blessedBA/sorting-warehouse/project_information/README.md

# Определение цвета предмета на фото и с веб-камеры

Первая версия для мини-склада: Python + OpenCV, без обучения нейросети.
Программа выделяет один светлый или цветной предмет на чёрном конвейере
и определяет его цвет, исключая фон.

## Установка и запуск

Нужен Python 3.10 или новее. В терминале из каталога проекта:

```bash
python3 -m venv .venv
source .venv/bin/activate
python -m pip install -r requirements.txt
python color_detector.py
```

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

Положите фотографии в папку `photos/` рядом с программой и запускайте без аргументов:

```bash
.venv/bin/python color_detector.py
```

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

При необходимости можно по-прежнему указать отдельную фотографию или другую папку:

```bash
python color_detector.py "/путь/к/фотографии.jpeg"
python color_detector.py "/путь/к/папке"
```

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

Например:

```text
output/
  ph_09.18 10.35/
    ph_09.18 10.35_result.jpg
    ph_09.18 10.35_mask.png
    ph_09.18 10.35_result.json
  ph_09.18 10.37/
    ph_09.18 10.37_result.jpg
    ph_09.18 10.37_mask.png
    ph_09.18 10.37_result.json
```

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

## Как выбирается предмет

Алгоритм рассчитан на **чёрный фон**. Чёрная лента при освещении может выглядеть
серой, поэтому порог яркости подбирается по снимку методом Оцу, но не опускается
ниже 95 по шкале 0…255. Светлые пиксели выше порога считаются кандидатами на предмет.
Насыщенные цветные пиксели выделяются дополнительно: насыщенность от 65,
яркость от 65, разница максимального и минимального канала от 40.
Это помогает находить, например, тёмно-синий предмет на тёмной ленте.

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

```bash
python color_detector.py photo.jpg --roi 100 600 1700 950
```

Это пример координат для крупного снимка; для своего изображения их нужно подобрать.

## Как определяется цвет

После выделения объекта программа немного отступает от его контура и переводит
пиксели в HSV. Цветовой тон определяет красный, оранжевый, жёлтый, зелёный,
голубой, синий, фиолетовый, розовый и коричневый. Яркость и насыщенность позволяют
отдельно выделять чёрный, серый и белый. Побеждает наиболее частый класс.
Пороговые значения находятся в функции `classifyPixels` в `color_detector.py`.

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

Это прототип для одного хорошо различимого предмета на чёрном фоне.
Чёрные предметы и почти чёрные участки исключаются вместе с фоном; первый пример
с чёрной мышкой на светлом столе больше не соответствует рабочему режиму.
Сильные блики на ленте, цветное освещение, малый контраст, прозрачные предметы
и яркий мусор могут приводить к ошибкам. Пороги нужно проверить на реальных
образцах при освещении склада. Если предмет касается края, он исключается;
дождитесь его полного появления в рабочей области.
Сначала проверяйте маску — она показывает, какой участок анализируется.

## Веб-камера: живое изображение с обводкой

Запуск из каталога проекта:

```bash
.venv/bin/python camera_detector.py
```

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

В окне камеры доступны клавиши (английская раскладка):

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

По умолчанию используется камера **0**. Если открылась встроенная камера вместо
подключённой веб-камеры, попробуйте:

```bash
.venv/bin/python camera_detector.py --camera 1
```

Индекс может быть 0, 1, 2 и т. д. Для меньшей нагрузки можно запросить 640×480:

```bash
.venv/bin/python camera_detector.py --camera 0 --width 640 --height 480
```

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

```bash
.venv/bin/python camera_detector.py --roi 100 50 600 400
.venv/bin/python main.py --port COM3 --weight-scale=123.45 --roi 100 50 600 400
```

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

### Фильтрация шума камеры

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

Пример более строгих настроек для живого просмотра:

```bash
.venv/bin/python camera_detector.py --min-area-fraction 0.005 --min-width 12 --min-height 12 --confirmation-frames 5
```

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

```bash
.venv/bin/python -m pip uninstall -y opencv-python-headless
.venv/bin/python -m pip install --upgrade -r requirements.txt
```

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

## Общая обработка фото и видео

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

## API камеры

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

```python
from camera import Camera

camera = Camera(camera_index=0, roi=(100, 60, 300, 300))
try:
    result = camera.detectObject()
    if result is not None:
        print(result["color"], result["rgb"], result["bbox"])
finally:
    camera.disconnect()
```

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

## API оборудования

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

```python
from hardware import Hardware

hardware = Hardware(com_port="COM3", baudrate=115200)
try:
    hardware.zero()
    responses = hardware.goto(10, 20)
    hardware.waitForMovement()
    print(responses)
finally:
    hardware.disconnect()
```

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

### Запуск сортировки из контроллера

Контроллер может запускать цикл `main.py` в фоне на уже открытом соединении:

```bash
.venv/bin/python controller.py --port /dev/cu.usbserial-3120 --weight-scale=123.45
```

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

```text
main start
weight fast continuous
```

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

## HX711: подключение и калибровка

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

## Главный цикл сортировки

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

```bash
.venv/bin/python main.py --port COM3 --camera 0 --feed-duration 0.8 --weight-duration 4 --weight-scale=123.45
```

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

## Проверка

```bash
.venv/bin/python -m unittest discover -s tests -v
```

Тесты проверяют основные цвета на чёрном фоне, тонкий белый предмет на текстурном
коврике с неравномерным освещением и светлыми краями, тёмные насыщенные цвета,
исключение чёрных отверстий, выбор предмета через ROI, разноцветный предмет,
пустой кадр и неверные координаты.
Проверки видеорежима используют последовательности искусственных кадров:
исчезновение предмета и смену цвета, сохранение снимков, отключение камеры и выход.
Фильтры шума проверяются на обоих фонах: мелкие постоянные пятна, короткие вспышки,
плавное движение, скачки положения/размера/цвета, сброс при потере кадра,
переподключении и изменении ROI/разрешения, а также настройка порогов.
Они не заменяют проверку изображения и разрешений на физической веб-камере.
Проверки главного цикла используют имитацию устройств: порядок операций,
поиск на пустой ленте и пропуск поиска при уже видимом предмете, подтверждение
реальным детектором на искусственных кадрах, повторение цикла, ошибки подачи
и движения, настройка времени, прерывание и освобождение оборудования.
Весовые тесты проверяют границы 5/12 г, выбор ячейки нужного ряда, усреднение
за заданное время, остановку ленты до измерения и подачу только после него,
ошибки и прерывание измерения до подачи, тарирование, калибровку, частичные ответы,
таймауты и восстановление serial-протокола. `test_firmware.py` компилирует
настоящий скетч с имитацией GPIO/Serial (нужен C++ компилятор) и проверяет
24-битные знаковые значения, старт, измерения, ошибки и отмену.
Эти тесты не заменяют калибровку и проверку физических весов.
