blessedBA/sorting-warehouse/electronics/kicad/README.md

# Схема склада в KiCad

Копия проекта от 17 октября 2026 года с четырьмя символами готовых
модулей. Открывайте `sorting-warehouse.kicad_pro`, затем редактор схемы.

- `U1` — `LM2596_Module`, понижающий преобразователь: два входных и два выходных
  контакта. Размещён вверху слева.
- `U2` — `MX1508_Module`, один канал двигателя конвейера: питание, два управляющих
  входа и два контакта двигателя. Размещён справа под A4988.
- `M1` — `SG90_Module`, сервопривод в виде жёлтого прямоугольника. Три вывода
  `SIG`, `V+`, `GND` сохраняют прежнюю нумерацию и точки подключения.
- `J_HX711` — `HX711_Module`, жёлтый прямоугольник вместо шестиконтактного
  разъёма. Сохранены шесть контактов `Pin_1`–`Pin_6`; их реальное назначение
  предстоит сверить с купленным модулем.

Это символы целых модулей с уже установленными деталями. Новые модули пока
не соединены проводами. Настройки проекта, существующие элементы, соединения,
файл платы и библиотека монтажных отверстий скопированы из исходного проекта.

## Выводы

| Модуль | Номер в символе | Имя | Назначение |
|---|---:|---|---|
| U1 | 1 | IN+ | Положительный вход питания |
| U1 | 2 | IN- | Отрицательный вход питания |
| U1 | 3 | OUT+ | Положительный выход питания |
| U1 | 4 | OUT- | Отрицательный выход питания |
| U2 | 1 | VIN+ | Питание драйвера двигателя |
| U2 | 2 | GND | Общий провод драйвера |
| U2 | 3 | IN1 | Первый управляющий вход |
| U2 | 4 | IN2 | Второй управляющий вход |
| U2 | 5 | OUT1 | Первый контакт двигателя |
| U2 | 6 | OUT2 | Второй контакт двигателя |

Нумерация логическая: она не задаёт физический порядок контактов на купленных
платах и не совпадает с нумерацией выводов отдельных микросхем. Посадочные места
не назначены. Перед разводкой нужно измерить модули и сопоставить эти номера
с площадками их посадочных мест. Выходное напряжение понижайки и напряжение
питания драйвера этим символом не задаются.

## Повторное добавление модулей

Библиотека `Warehouse_Modules.kicad_sym` подключена локально через
`sym-lib-table`. В редакторе схем нажмите **A**, найдите `LM2596_Module`,
`MX1508_Module`, `SG90_Module` или `HX711_Module` и разместите экземпляр.
Выводы, имена и обозначение уже входят
в символ и перемещаются вместе. При переносе проекта сохраняйте библиотеку
и `sym-lib-table` рядом с `.kicad_pro`.

Для подключения нажмите **W** у нужного вывода; метку цепи добавьте клавишей
**L**. Перемещение символа — **M**, перемещение с сохранением проводов — **G**.

## Проверка

KiCad CLI 10.0.7 успешно экспортировал схему и библиотечные символы в SVG,
а схему — в список соединений. Все прежние соединения совпадают с исходными.
Число выводов и их названия проверены по экспортированному списку соединений.

ERC не пройден: схема ещё не соединена полностью. После изменения оформления
HX711 и сервопривода осталось 97 замечаний. Число выводов и их номера сохранены,
а список соединений совпадает с версией до изменения оформления.
