blessedBA/sorting-warehouse/project_information/photo_2026-11-12 21.13.13.jpeg

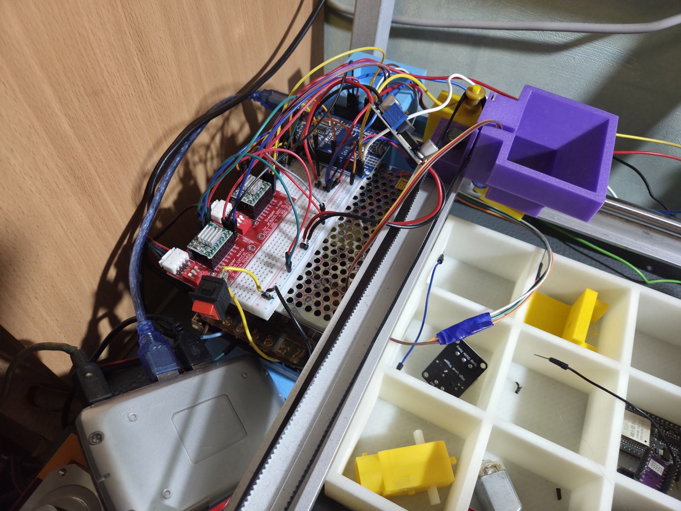
project_information/photo_2026-11-12 21.13.13.jpeg
