blessedBA/sorting-warehouse/CAD&blueprints/V7/Print/Head.stp

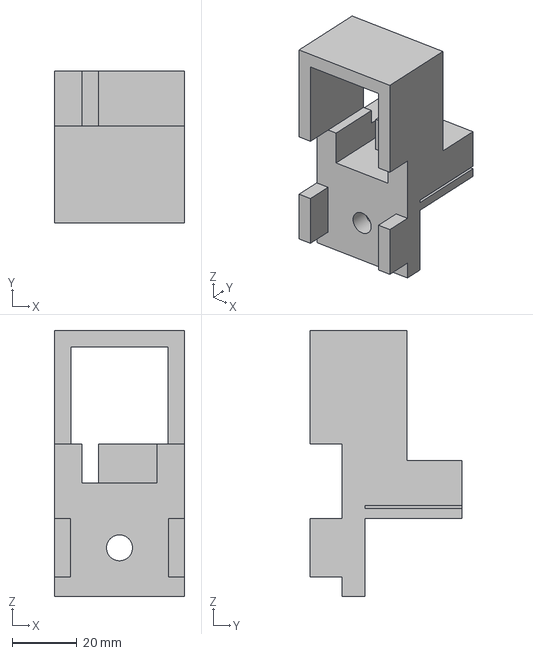
[picture p13: CAD file, 2026-09-20]
CAD&blueprints/V7/Print/Head.stp
40.1 x 47.0 x 82.0 mm
