blessedBA/sorting-warehouse/CAD&blueprints/V7/Print/Conveyor_support.stp

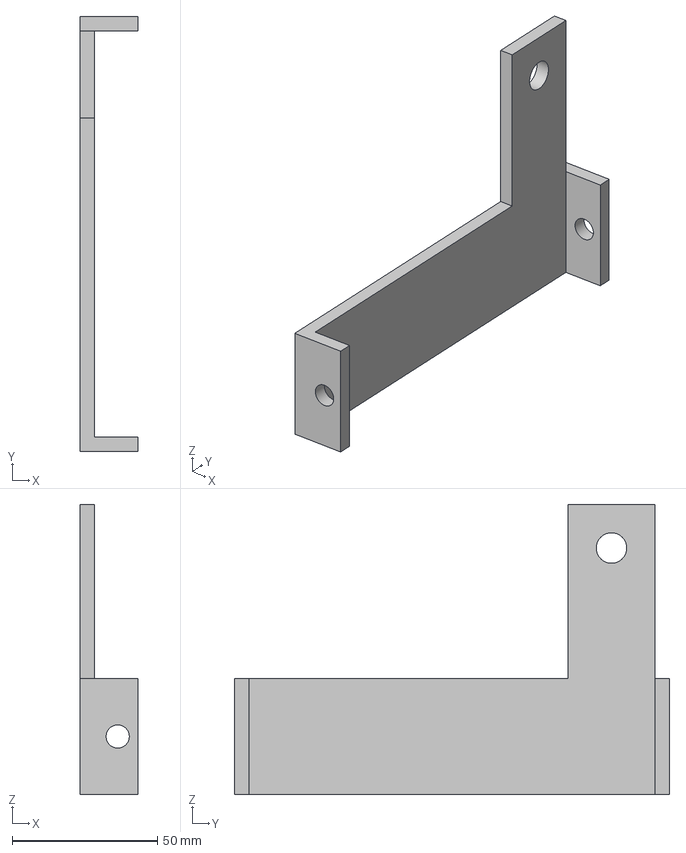
[picture p14: CAD file, 2026-09-20]
CAD&blueprints/V7/Print/Conveyor_support.stp
20.0 x 150.0 x 100.0 mm
