blessedBA/sorting-warehouse/CAD&blueprints/V7/Print/Conveyor_cylinder.stp

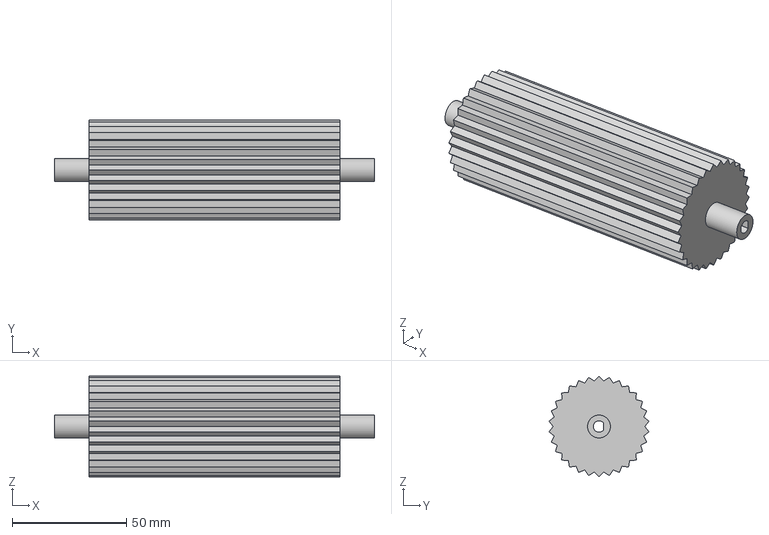
[picture p15: CAD file, 2026-09-20]
CAD&blueprints/V7/Print/Conveyor_cylinder.stp
140.0 x 43.8 x 44.0 mm
