blessedBA/sorting-warehouse/CAD&blueprints/V2/Print/HeadRail.stp

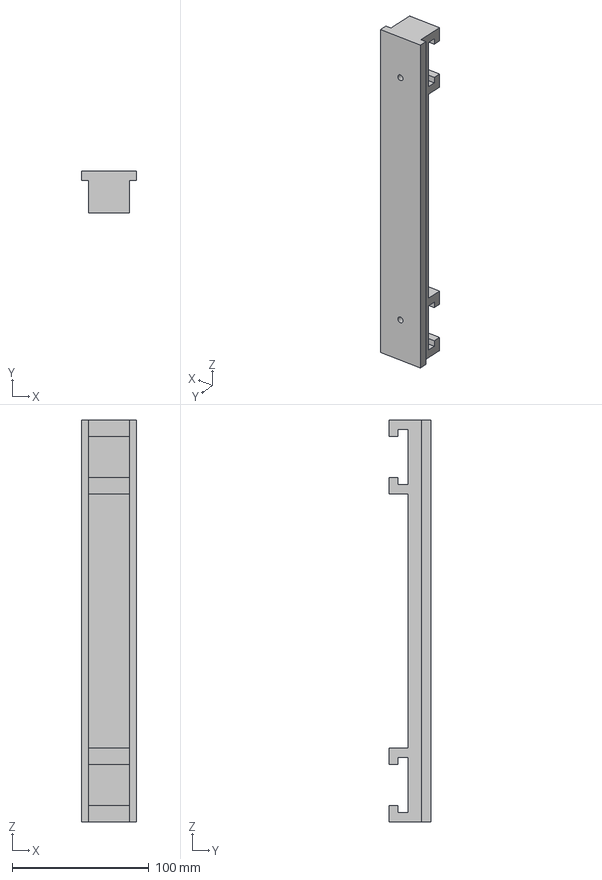
[picture p16: CAD file, 2026-09-20, an earlier design]
CAD&blueprints/V2/Print/HeadRail.stp
40.0 x 31.0 x 294.2 mm
