blessedBA/sorting-warehouse/CAD&blueprints/V3/Print/Base.stp

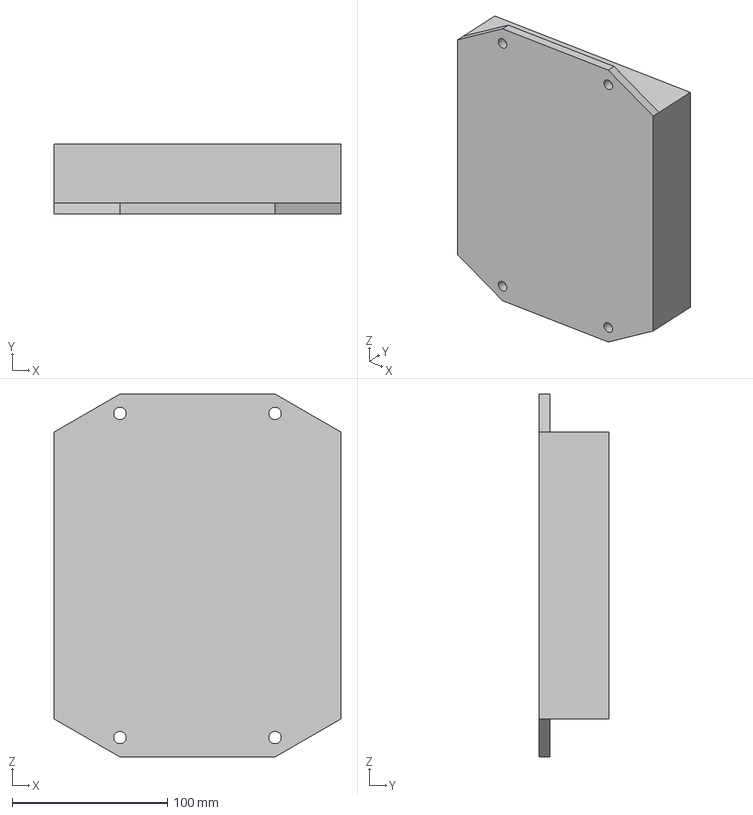
[picture p17: CAD file, 2026-09-20, an earlier design]
CAD&blueprints/V3/Print/Base.stp
185.0 x 45.0 x 234.1 mm
