blessedBA/sorting-warehouse/CAD&blueprints/V5/Print/Cube.stp

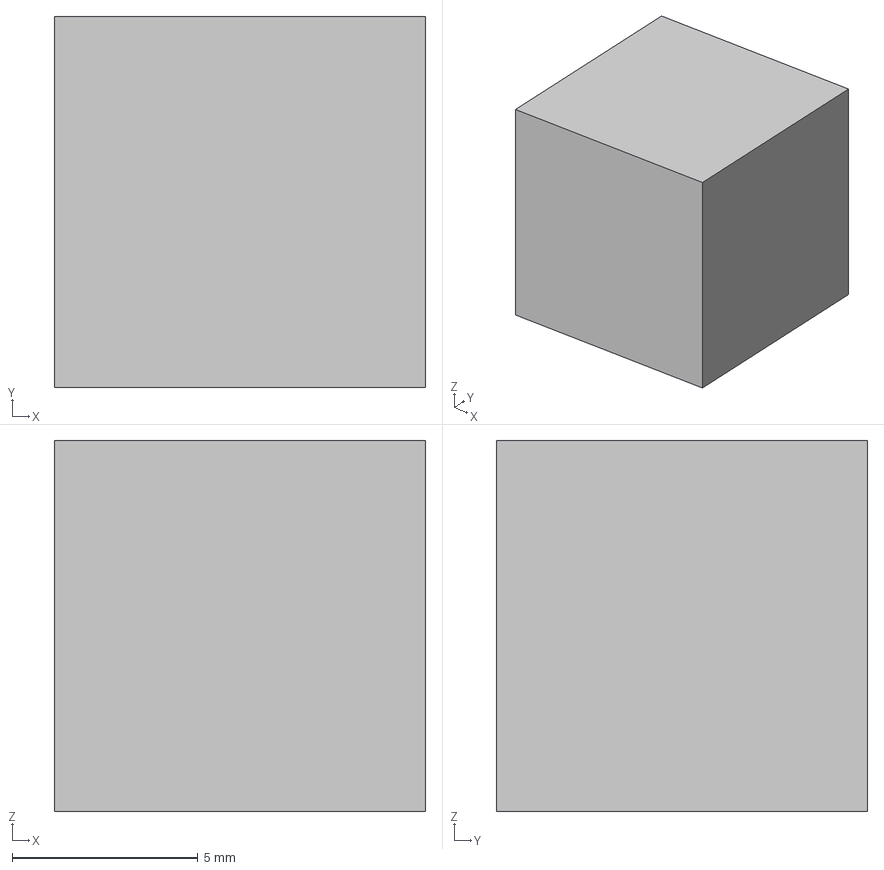
[picture p19: CAD file, 2026-09-20, an earlier design]
CAD&blueprints/V5/Print/Cube.stp
10.0 x 10.0 x 10.0 mm
