blessedBA/sorting-warehouse/CAD&blueprints/V6/Print/Head_floor.stp

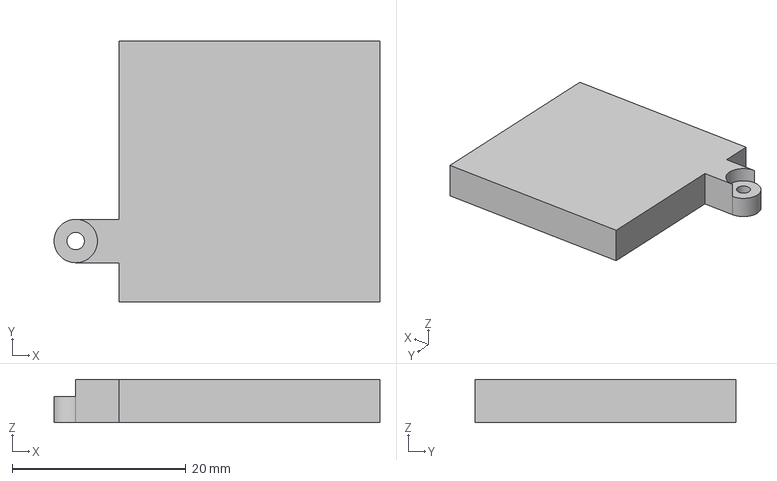
[picture p20: CAD file, 2026-09-20, an earlier design]
CAD&blueprints/V6/Print/Head_floor.stp
37.5 x 30.0 x 5.00 mm
