blessedBA/sorting-warehouse/CAD&blueprints/V2/Print/Back_right.stp

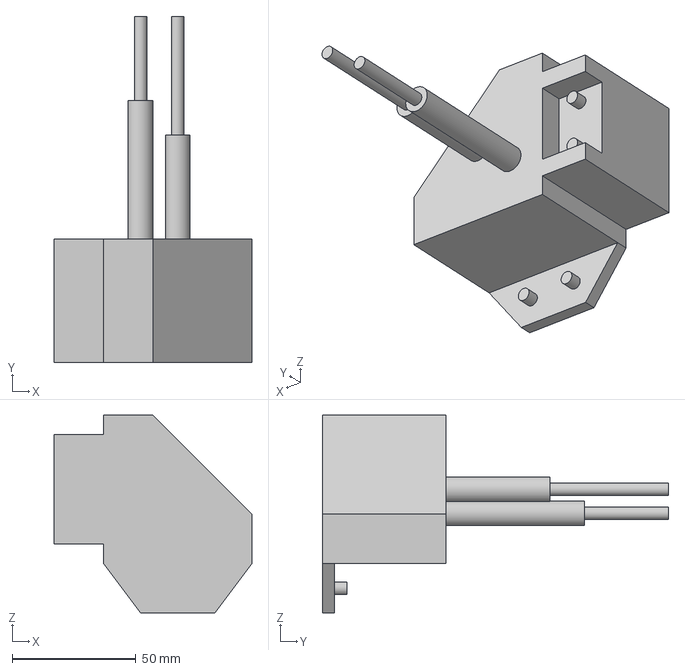
[picture p21: CAD file, 2026-09-20, an earlier design]
CAD&blueprints/V2/Print/Back_right.stp
80.0 x 140.0 x 80.0 mm
