blessedBA/sorting-warehouse/CAD&blueprints/V3/Print/Connector_front.stp

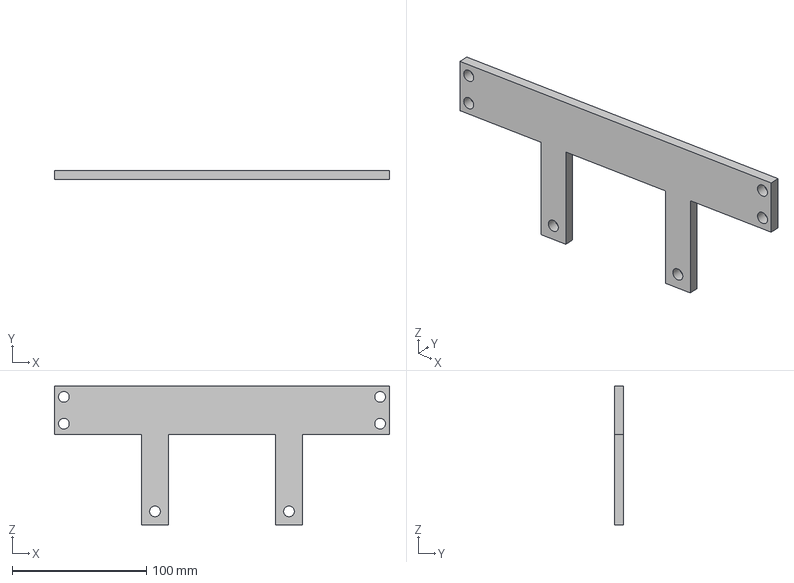
[picture p22: CAD file, 2026-09-20, an earlier design]
CAD&blueprints/V3/Print/Connector_front.stp
250.0 x 7.00 x 103.5 mm
