blessedBA/sorting-warehouse/CAD&blueprints/V5/Print/Connector_field.stp

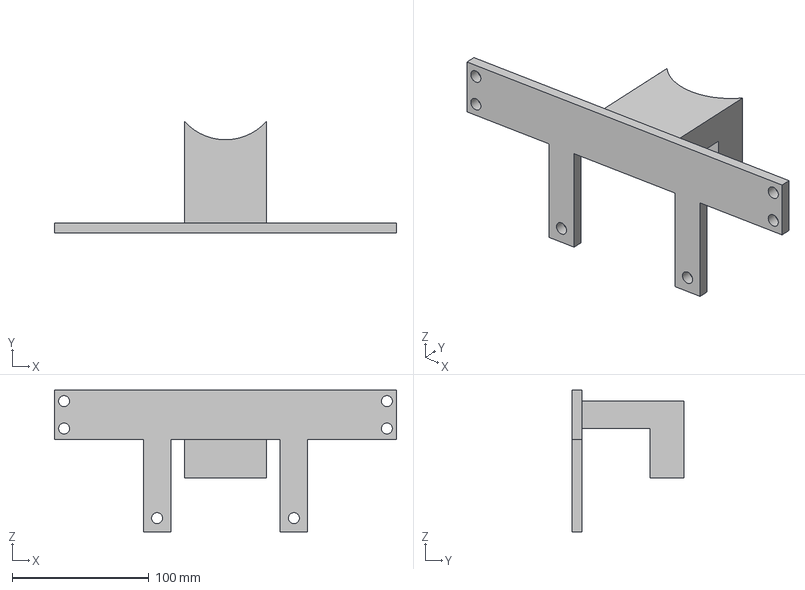
[picture p23: CAD file, 2026-09-20, an earlier design]
CAD&blueprints/V5/Print/Connector_field.stp
250.0 x 81.5 x 103.5 mm
