blessedBA/sorting-warehouse/CAD&blueprints/V6/Print/Head.stp

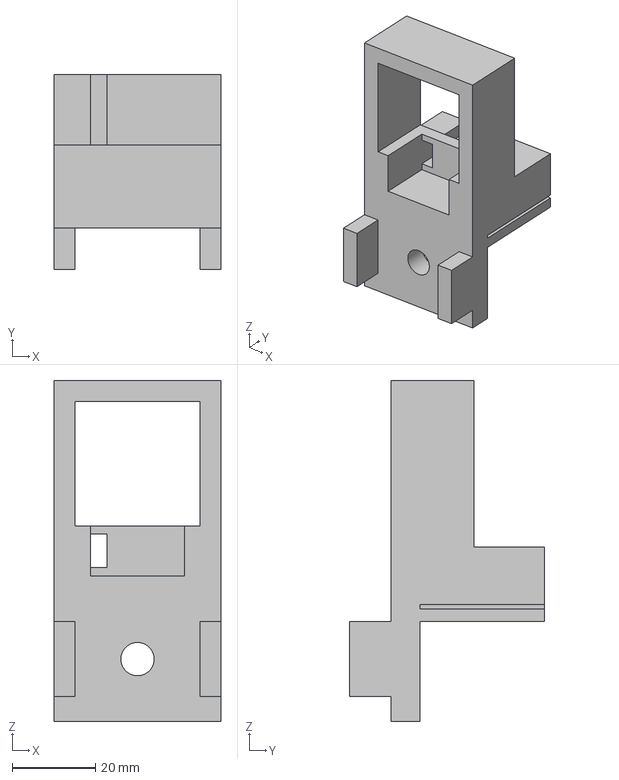
[picture p24: CAD file, 2026-09-20, an earlier design]
CAD&blueprints/V6/Print/Head.stp
40.1 x 47.0 x 82.0 mm
