blessedBA/sorting-warehouse/CAD&blueprints/V2/Print/Rail.stp

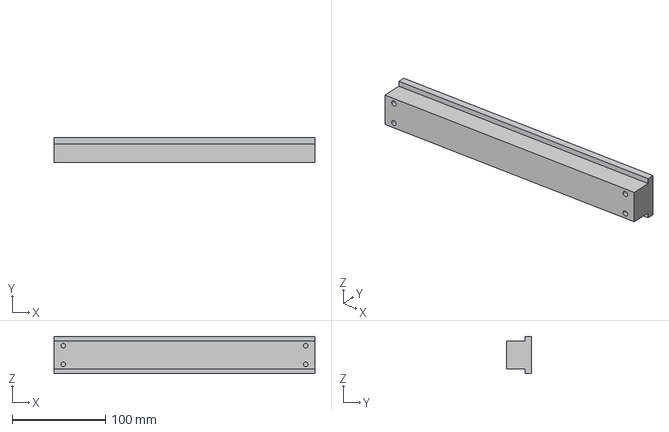
[picture p25: CAD file, 2026-09-20, an earlier design]
CAD&blueprints/V2/Print/Rail.stp
280.0 x 27.0 x 40.0 mm
