blessedBA/sorting-warehouse/CAD&blueprints/V3/Print/Head_rail_connector.stp

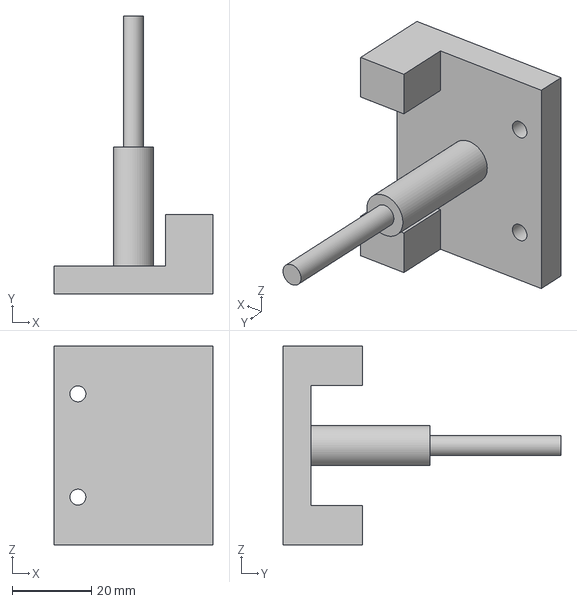
[picture p26: CAD file, 2026-09-20, an earlier design]
CAD&blueprints/V3/Print/Head_rail_connector.stp
40.0 x 70.0 x 50.1 mm
