blessedBA/sorting-warehouse/CAD&blueprints/V2/Print/Connector_low.stp

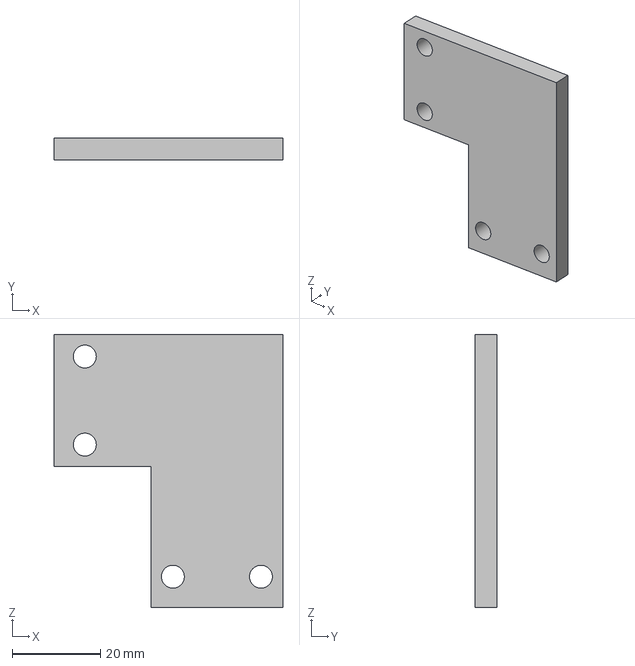
[picture p28: CAD file, 2026-09-20, an earlier design]
CAD&blueprints/V2/Print/Connector_low.stp
52.0 x 5.00 x 62.0 mm
