blessedBA/sorting-warehouse/CAD&blueprints/V3/Print/Head.stp

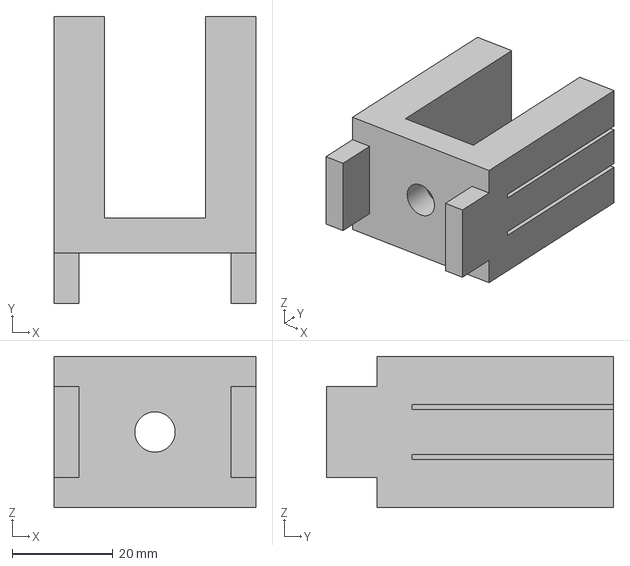
[picture p29: CAD file, 2026-09-20, an earlier design]
CAD&blueprints/V3/Print/Head.stp
40.1 x 57.0 x 30.0 mm
