blessedBA/sorting-warehouse/(list of files, cad)

Other CAD files:
CAD&blueprints/V7/Print/Conveyor_support_L.stp
CAD&blueprints/V2/Print/Back_left.stp
CAD&blueprints/V2/Print/Connector_back.stp
CAD&blueprints/V2/Print/Head.stp
CAD&blueprints/V2/Print/Pylon_HeadRail.stp
CAD&blueprints/V2/Print/ServoHolder_left.stp
CAD&blueprints/V2/Print/ServoHolder_right.stp
CAD&blueprints/V2/Print/Slots.stp
CAD&blueprints/V3/Print/Back_left.stp
CAD&blueprints/V3/Print/Back_right.stp
CAD&blueprints/V3/Print/ServoHolder_left.stp
CAD&blueprints/V3/Print/ServoHolder_right.stp
CAD&blueprints/V5/Print/Grabber.stp
