blessedBA/sorting-warehouse/electronics/kicad/preview.pdf

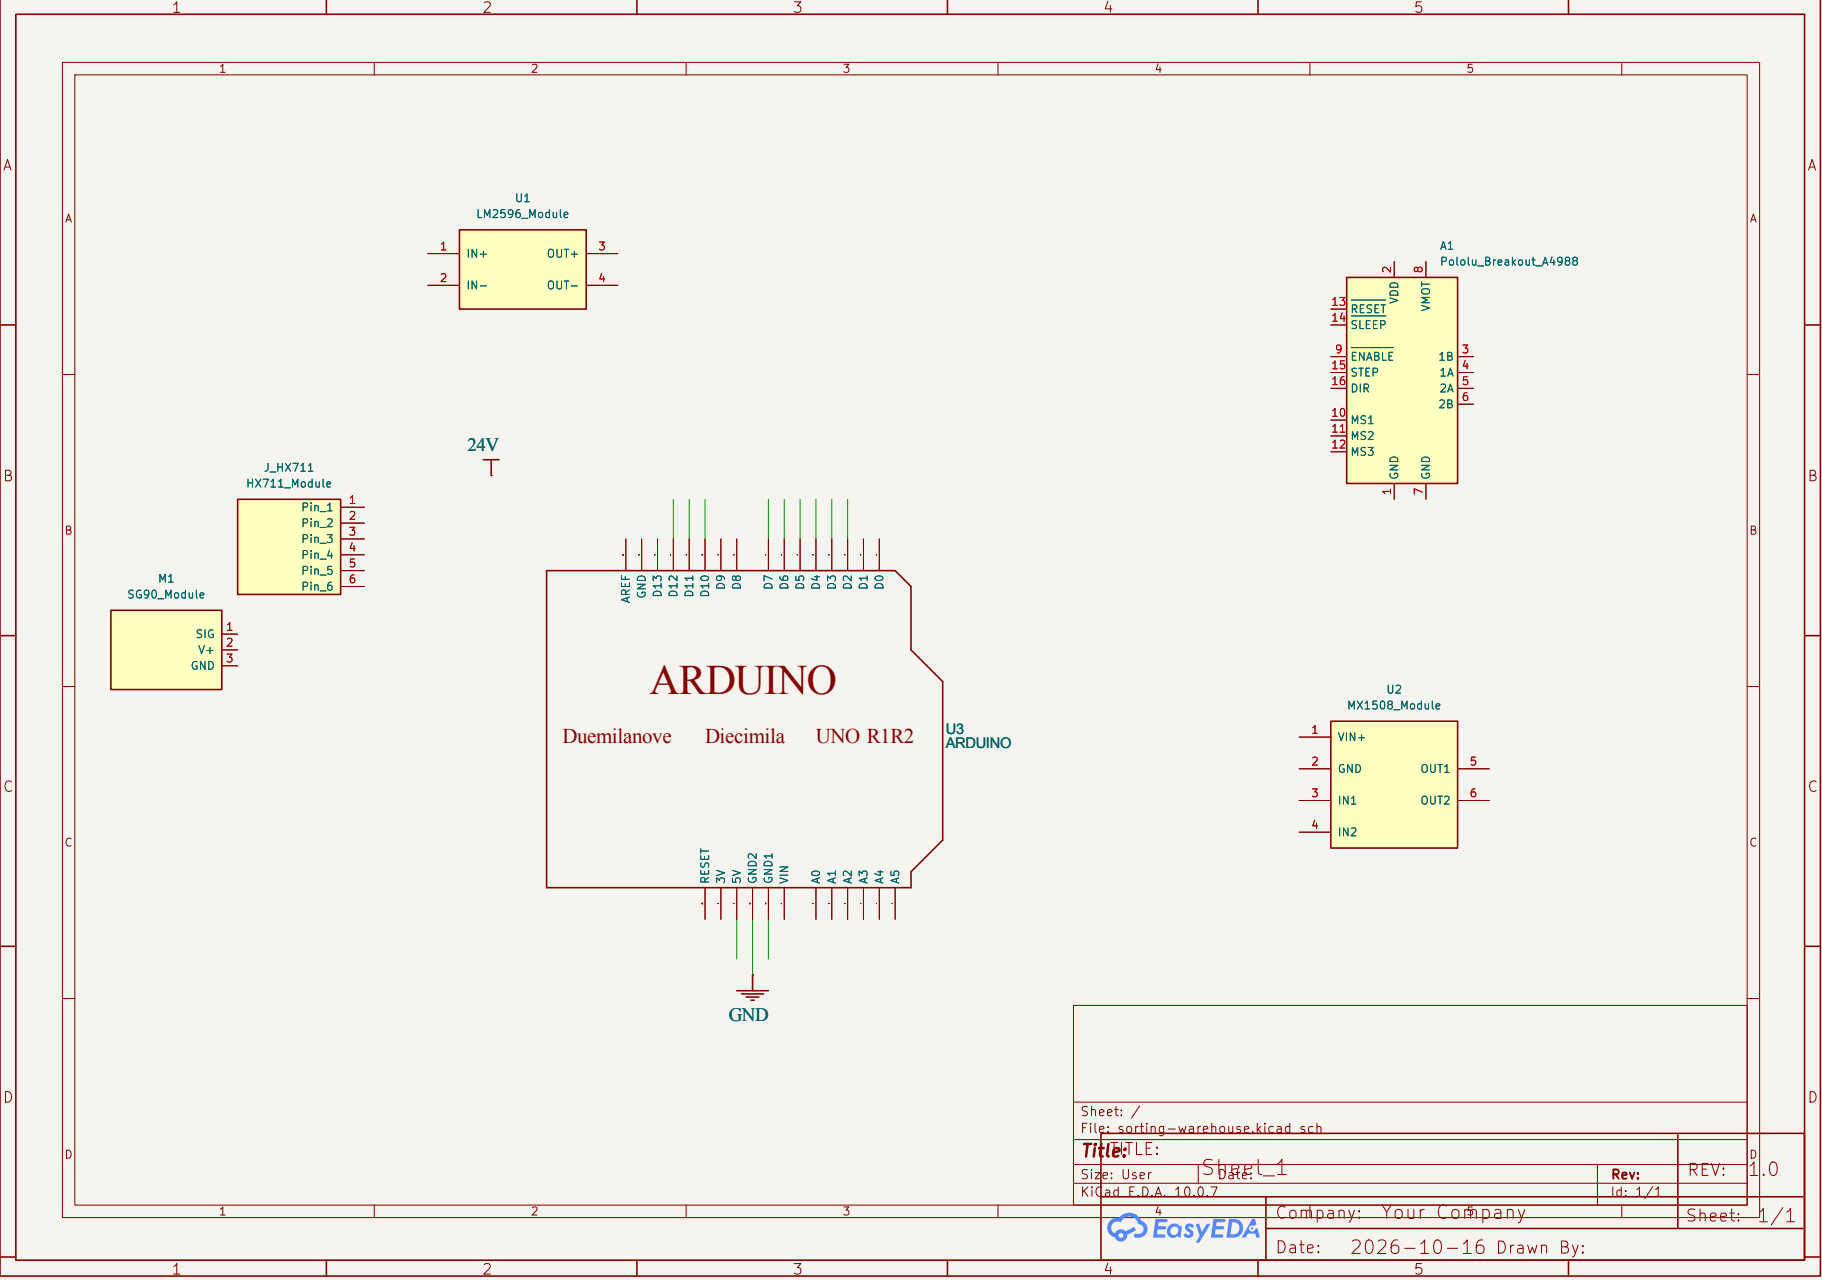
[picture p30: page 1]

Title: | TITLE:
Size: User | | Sheet_1 | Rev: | REV:
KiCad E.D.A. 10.0.7 | | | Id: 1/1

Sheet:
