blessedBA/sorting-warehouse/(commit log)

2026-09-18 v2.0 camera deterction works
2026-09-20 v3.0 created a architecture of software
    [Back_left.stp, Back_right.stp, Base.stp, Connector_back.stp, Connector_field.stp, Connector_front.stp, Connector_low.stp, Conveyor_cylinder.stp]
2026-09-22 added driver's code & updated hardware exceptions
2026-09-23 added color printing
2026-09-27 conveyor driver & hardware & main
2026-09-28 relay duty driver
2026-09-28 fix camera detection a bit
    [camera_detector.py]
2026-09-30 updated conveyor driver
2026-10-20 added tensosensor
    [sorting-warehouse.kicad_pcb, sorting-warehouse.kicad_sch]
2026-11-05 base behavior of tensor sensor
